NeXan87/Auto-Spray/(list of files, drawings)

Other design files:
Electric Diagram/Smart-Air-Freshener.pdsprj
