NeXan87/Auto-Spray/Firmware/Smart-Air-Freshener/state.h

#pragma once

#include "config.h"
#include "utils.h"
#include <Bounce2.h>

void initStateMachine();
void updateStateMachine(SprayMode currentMode, bool isLightOn);
bool hasLightOn();
void resetState();

extern State currentState;
extern Bounce button;
