NeXan87/Auto-Spray/(commit log)

2025-11-19 Update README.md
    Создает README.md
2025-11-21 Оптимизирует код под 328P
2025-11-22 Добавляет проверку светодиодов при старте
2025-11-22 Подключает библиотеку Bounce2
2025-11-22 Изменяет gitignore
2025-11-23 Добавляет фоторезистор
    [Auto-Spray [20251121, 22-57-35].pdsprj, Auto-Spray [20251121, 23-06-02].pdsprj, Auto-Spray [20251121, 23-19-29].pdsprj, Auto-Spray [20251121, 23-27-33].pdsprj, Auto-Spray [20251122, 02-01-43].pdsprj, Auto-Spray.pdsprj]
2025-11-24 Подключает драйвер коллекторного двигателя
2025-11-25 Обновляет эл. схему
    [Auto-Spray.pdsprj]
2025-11-26 Переводит схему на 3,3В
    [Auto-Spray.pdsprj]
2025-11-26 Добавляет возможность подключение светодиода с общим катодом или анодом
2025-11-28 Добавляет отключение драйвера мотора при простое
2025-11-28 Форматирует код
2025-11-28 Делает пищалку пассивной
    [Auto-Spray.pdsprj]
2025-12-03 Удаляет пин 12, а транзистор соединяет с 10 и 11 диодами
    [Auto-Spray.pdsprj]
2025-12-03 Перемещает BUZZER с 9 на 12 пин
    [config.h]
2025-12-04 Меняет период мигания светодиодом
    [Auto-Spray.pdsprj]
2025-12-05 Исправляет режим сна
    [Auto-Spray.pdsprj]
2025-12-07 Добавляет переключатель количество пшиков с 1 по 4
    [Auto-Spray.pdsprj]
2025-12-08 Обновляет некоторые баги
2025-12-13 Делает небольшие исправления
2025-12-14 Добавляет контроль заряда батареи
    [Auto-Spray.pdsprj]
2025-12-15 Исправляет работу пшика во время сна
    [state.cpp]
2025-12-15 Отключает SERIAL
    [Auto-Spray.pdsprj]
2025-12-16 Переименовывает название проекта
2025-12-16 Переименовывает файл изображения
2025-12-16 Обновляет README
2025-12-16 Переименовывает файлы
    [Smart-Air-Freshener.pdsprj]
